deskpro256/Kinetics_Rev_counter/Images/set-current-max.jpg

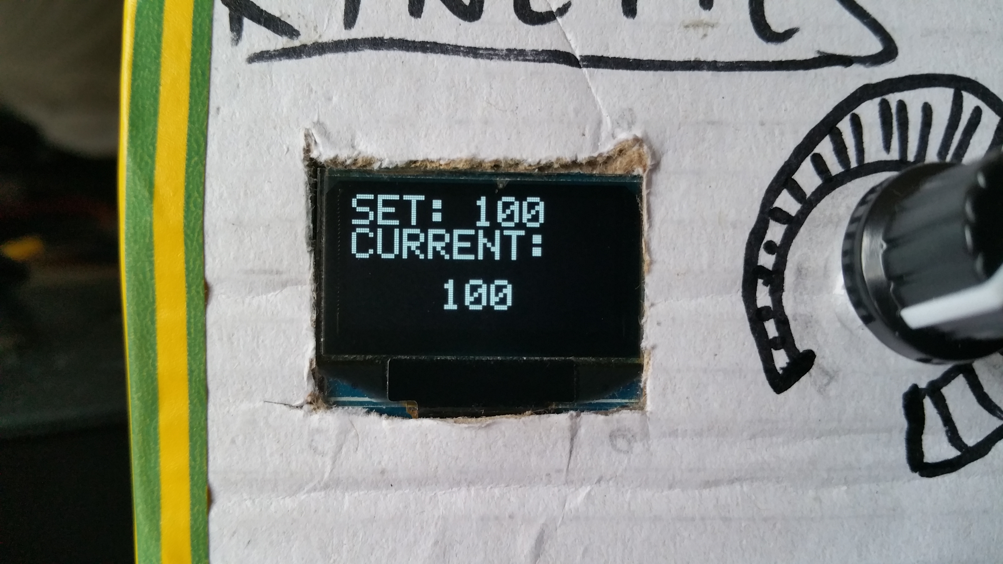
Images/set-current-max.jpg
