deskpro256/Kinetics_Rev_counter/Images/edited/set_limit.jpg

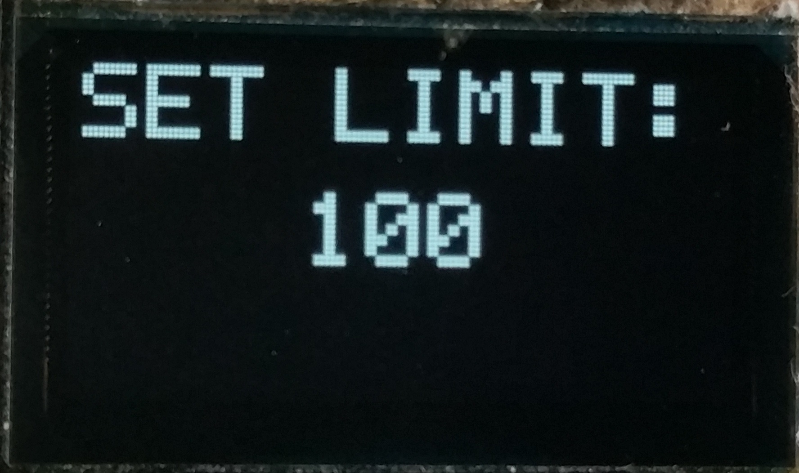
Images/edited/set_limit.jpg
