deskpro256/Kinetics_Rev_counter/Panel/Kinetics front.pdf

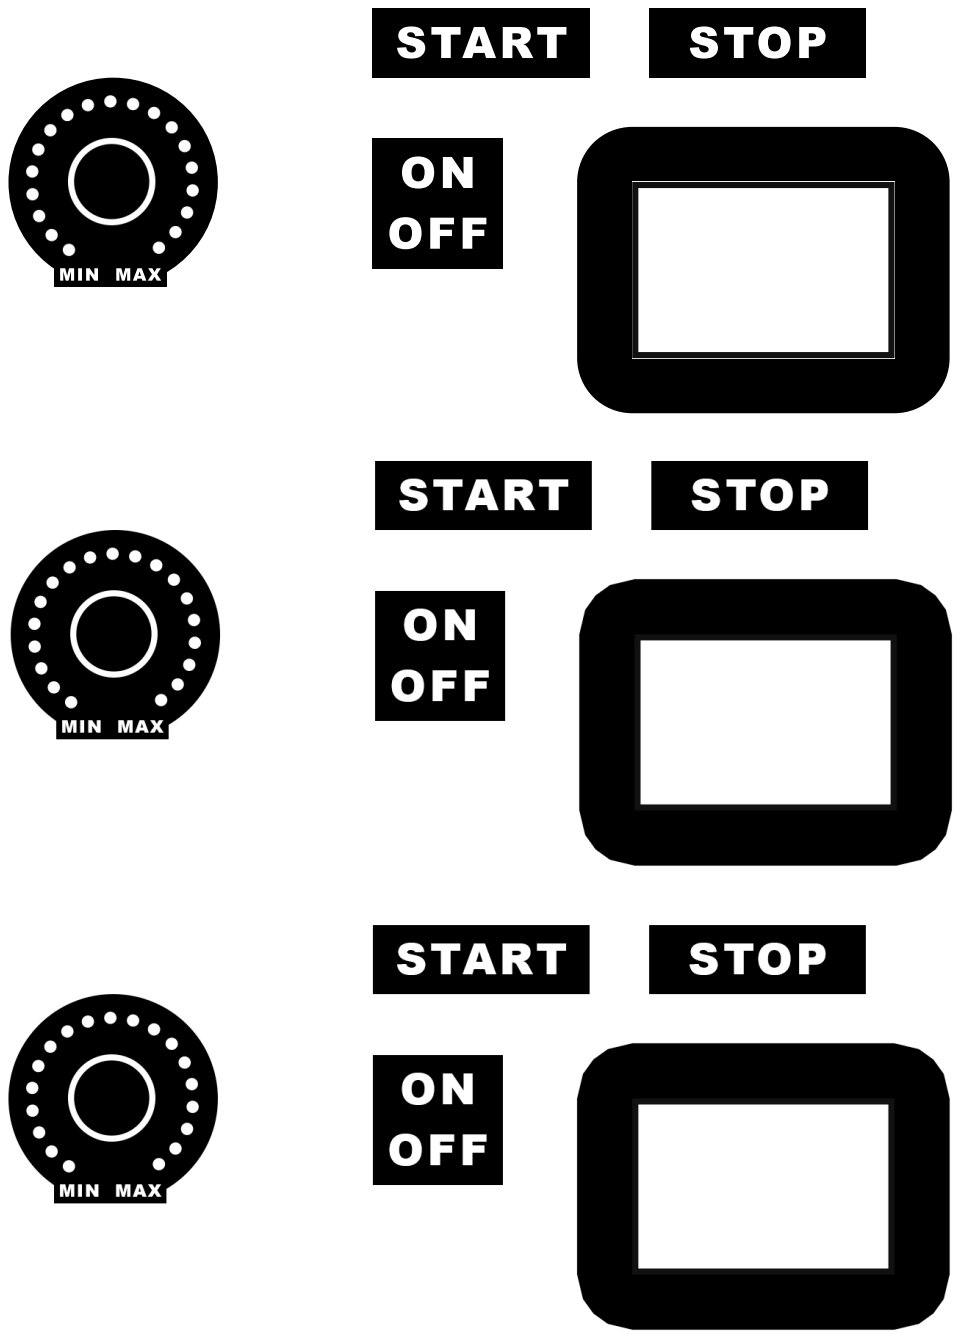
[picture p11: page 1]

MIN MAX

ON
OFF

START STOP
