deskpro256/Kinetics_Rev_counter/Hardware/Schematic/Schematic_Kinetics-rev-counter.png

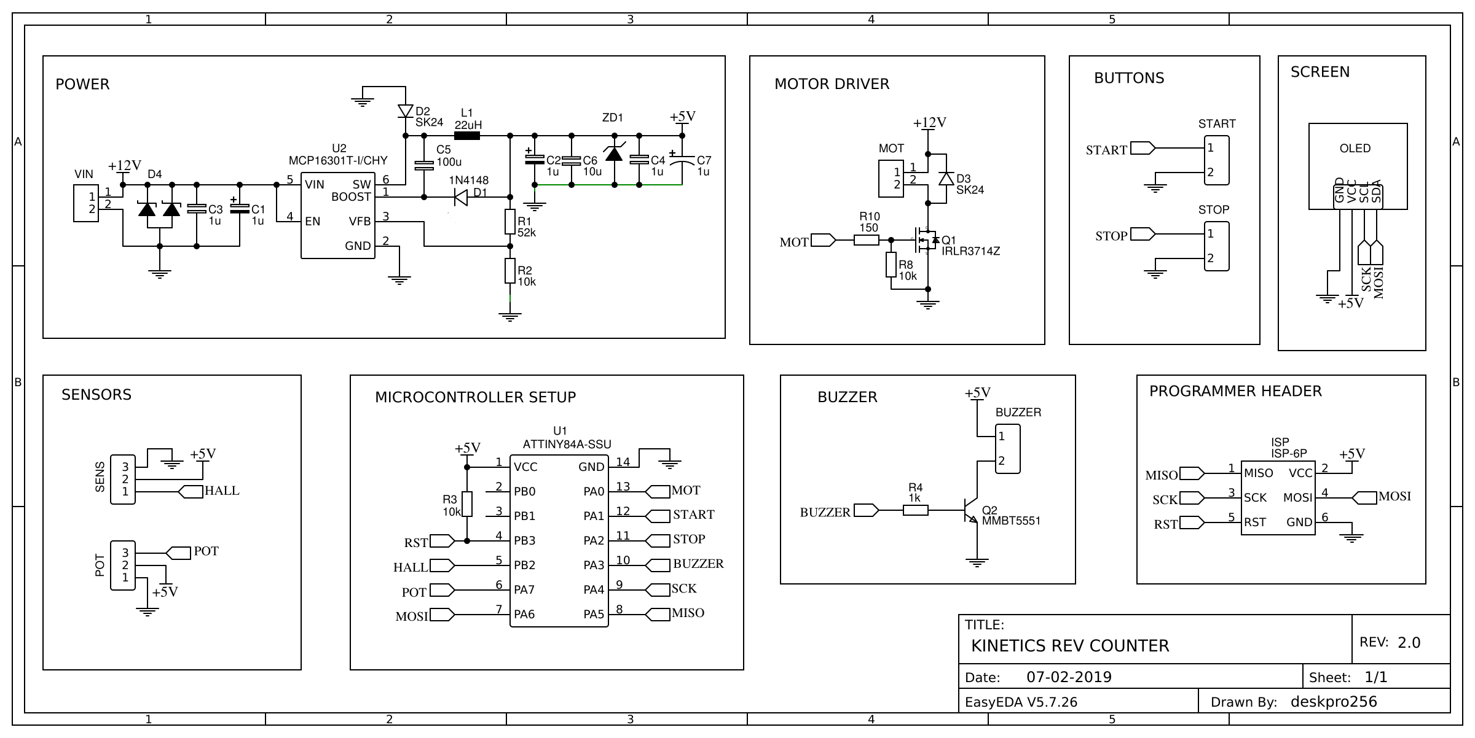
Hardware/Schematic/Schematic_Kinetics-rev-counter.png
