deskpro256/Kinetics_Rev_counter/Images/counting done.jpg

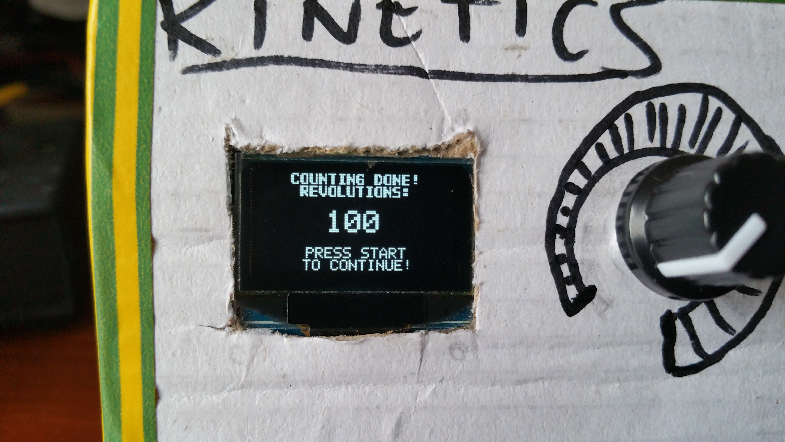
Images/counting done.jpg
