deskpro256/Kinetics_Rev_counter/Images/edited/finished panel.jpg

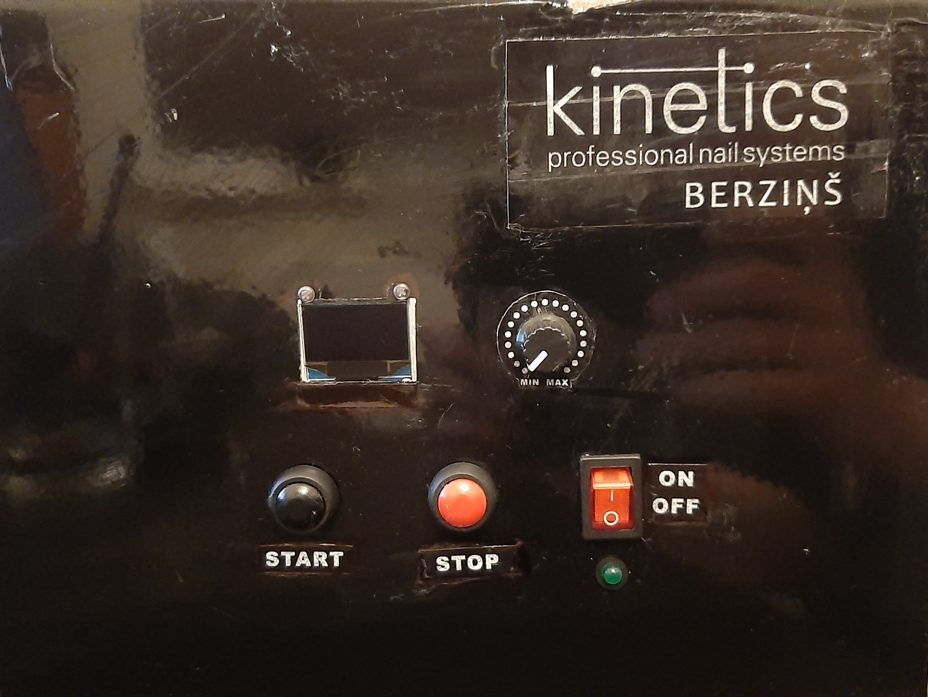
Images/edited/finished panel.jpg
