deskpro256/Kinetics_Rev_counter/Images/edited/panel.jpg

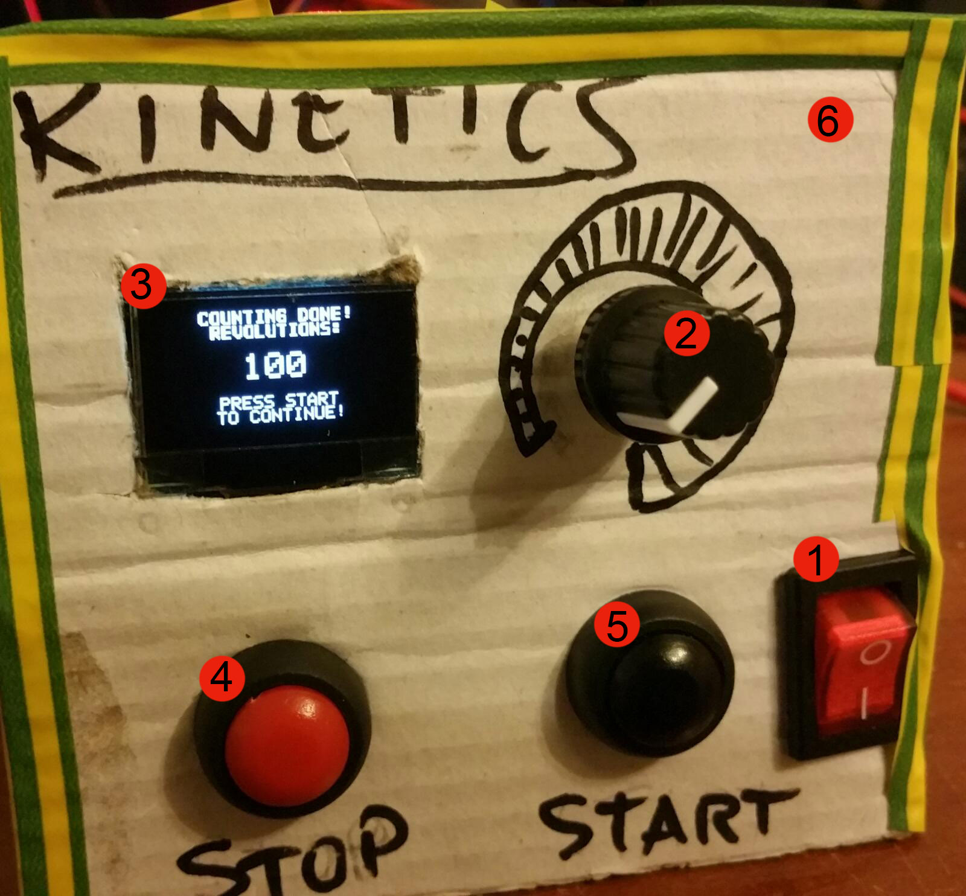
Images/edited/panel.jpg
