deskpro256/Kinetics_Rev_counter/Images/edited/pcb_live.jpg

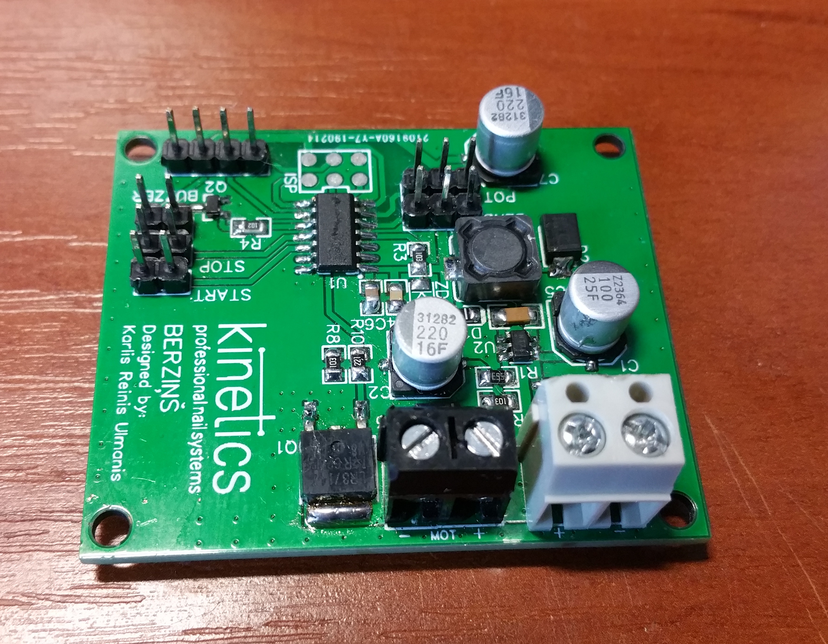
Images/edited/pcb_live.jpg
