deskpro256/Kinetics_Rev_counter/Images/finished panel.jpg

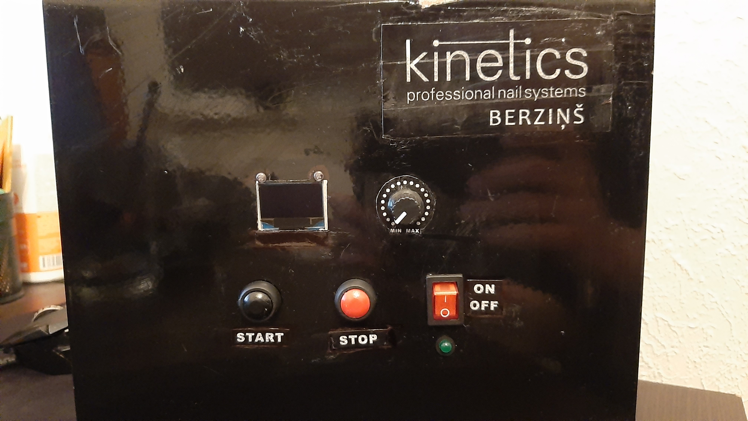
Images/finished panel.jpg
