deskpro256/Kinetics_Rev_counter/Images/pcb IRL 2.jpeg

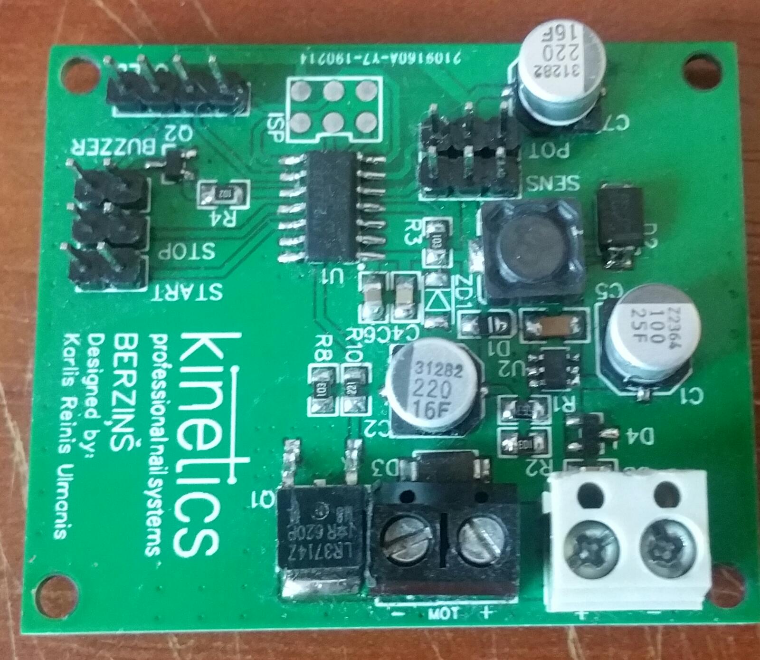
Images/pcb IRL 2.jpeg
