deskpro256/Kinetics_Rev_counter/Images/set limit.jpg

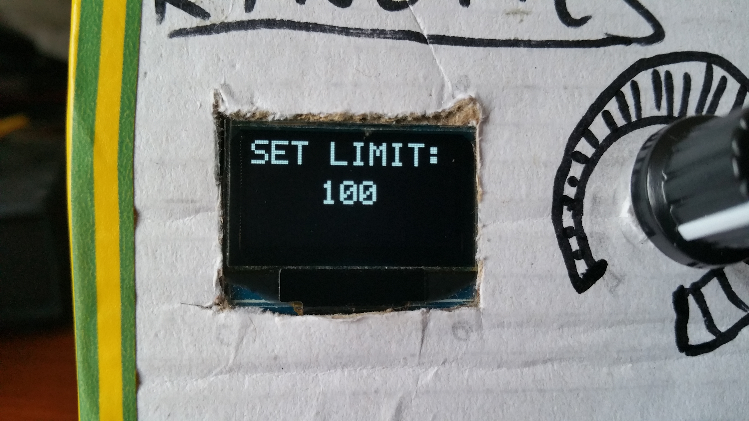
Images/set limit.jpg
