deskpro256/Kinetics_Rev_counter/Images/set-current-down.jpg

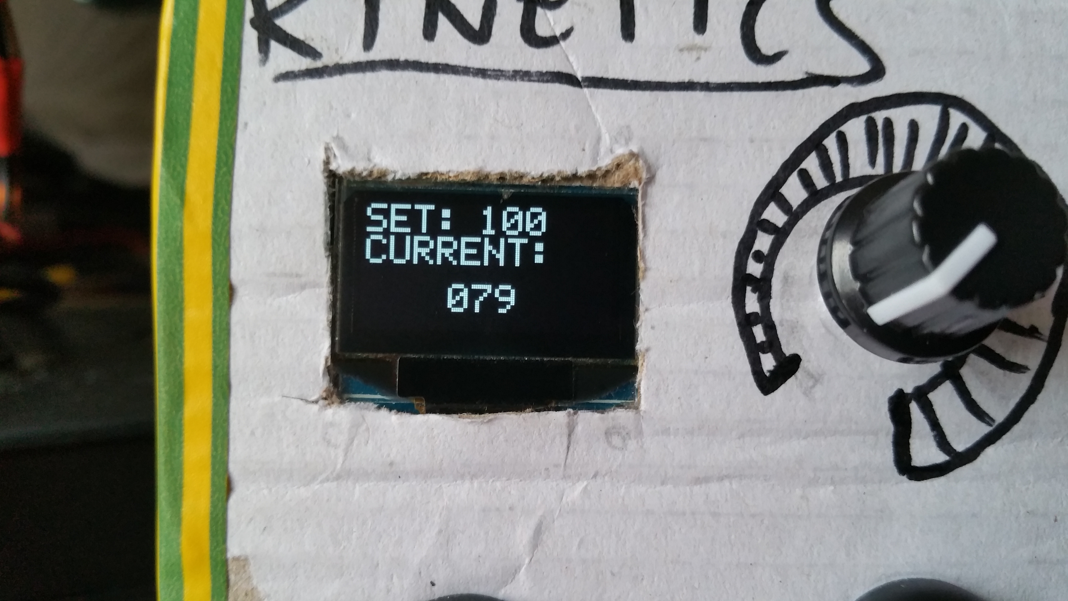
Images/set-current-down.jpg
