deskpro256/Kinetics_Rev_counter/Images/stop reset.jpg

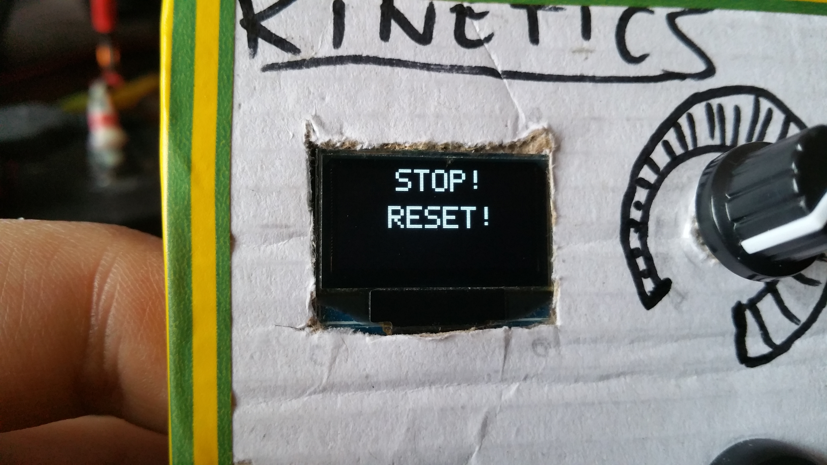
Images/stop reset.jpg
