deskpro256/Kinetics_Rev_counter/Hardware/Schematic/Schematic_Kinetics_rev_counter_2020-06-20_01-05-08.pdf

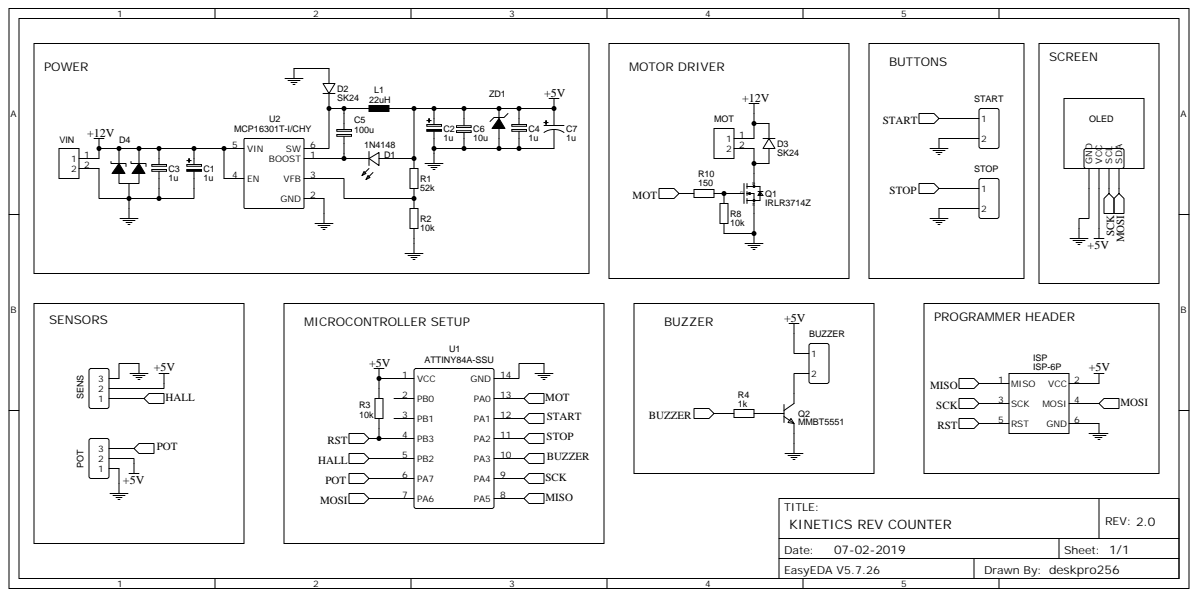
[picture p22: page 1]

OLED GND VCC SCL
