deskpro256/Kinetics_Rev_counter/Panel/panel_outlines.pdf

120

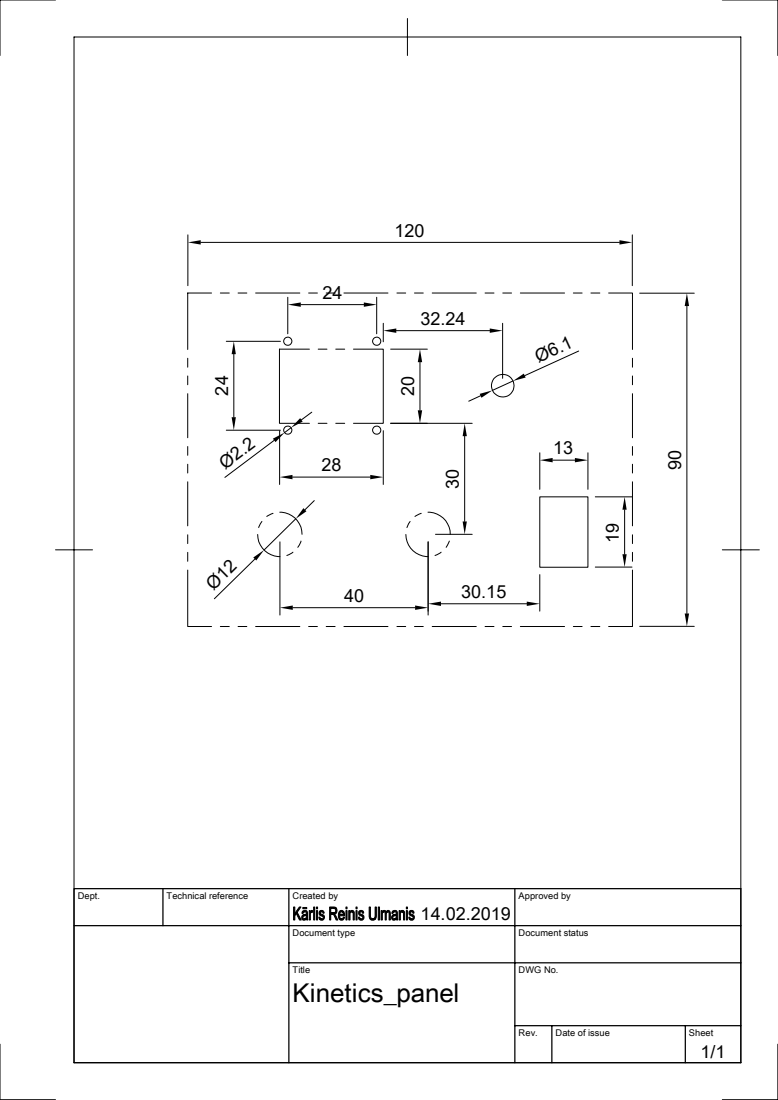
[picture p23: page 1]
Dept.; Technical reference; Created by; Approved by

Document type | Document status

Title Kinetics_panel | DWG No.

Rev. | Date of issue | Sheet 1/1
