deskpro256/Kinetics_Rev_counter/(commit log)

2019-02-12 First commit, adding all files to github for VC
    [BOM.xls]
2019-02-14 adding new info to specification as well as panel dimensions
    [BOM.xls]
2019-04-06 added interrupt on Hall effect sensor, some bug fixes
2019-06-05 Removed unnecessary files, cleaned up project file, working on the TEX specification sheet, renamed arduino file
2020-06-19 added some more documentation and updated the folder management
    [BOM.xls]
2020-06-19 added some structure to the folders and som edocumentation added
    [BOM.xls]
